Jannled/LedCube/Bilder/20170320_181509.jpg

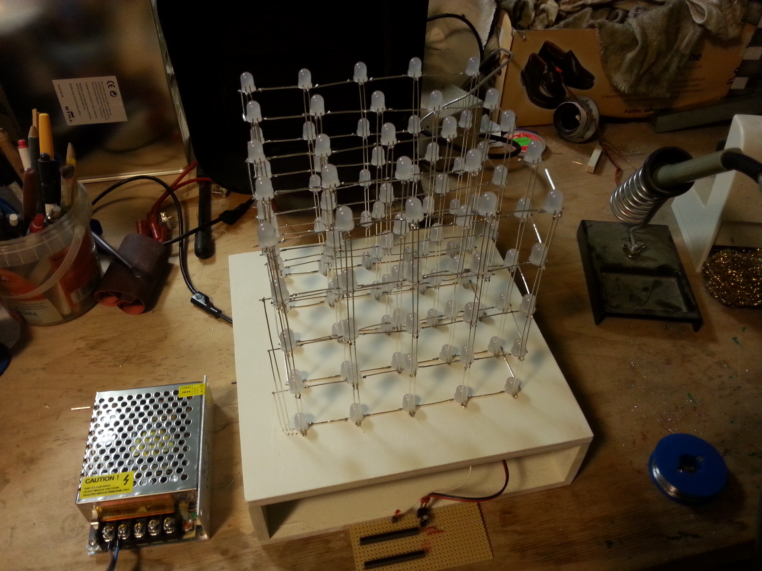
Bilder/20170320_181509.jpg
