Jannled/LedCube/Bilder/20170222_165625.jpg

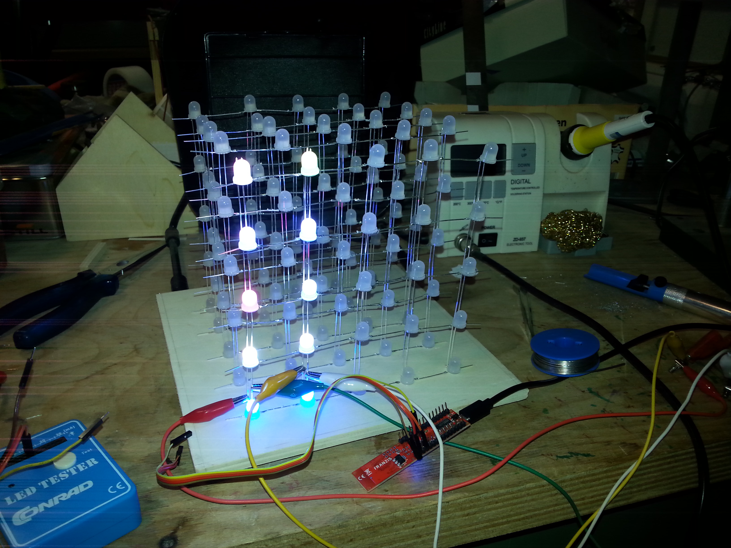
Bilder/20170222_165625.jpg
