Jannled/LedCube/README.md

# LedCube
Facharbeit 01 - Ansteuerung einer 5x5x5 LED-Matrix mit einem Microcontroller
