Jannled/LedCube/Abmessungen/rect4140.png

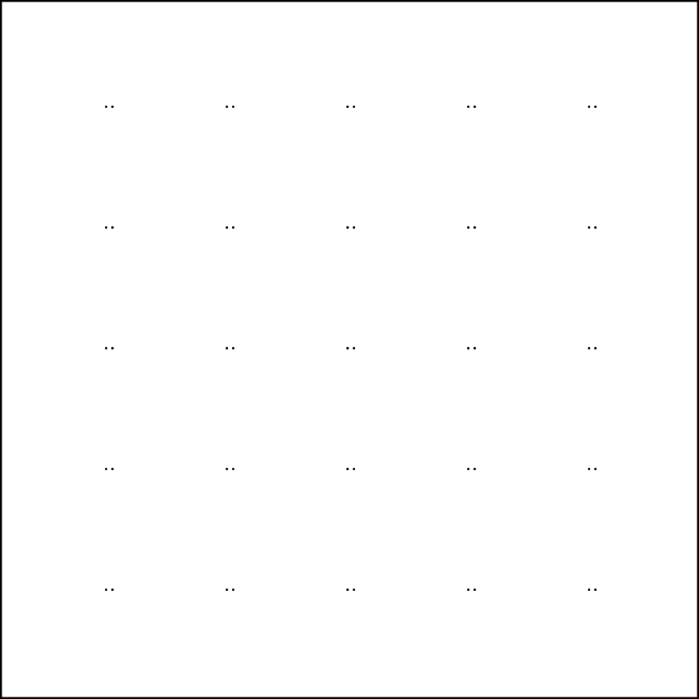
Abmessungen/rect4140.png
