Jannled/LedCube/Bilder/20170205_150405.jpg

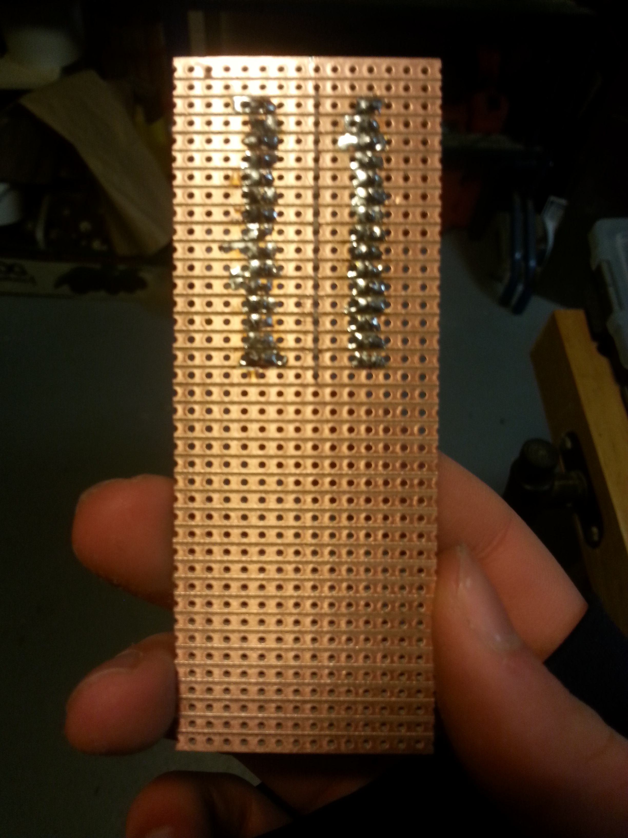
Bilder/20170205_150405.jpg
