Jannled/LedCube/Bilder/20170216_102611.jpg

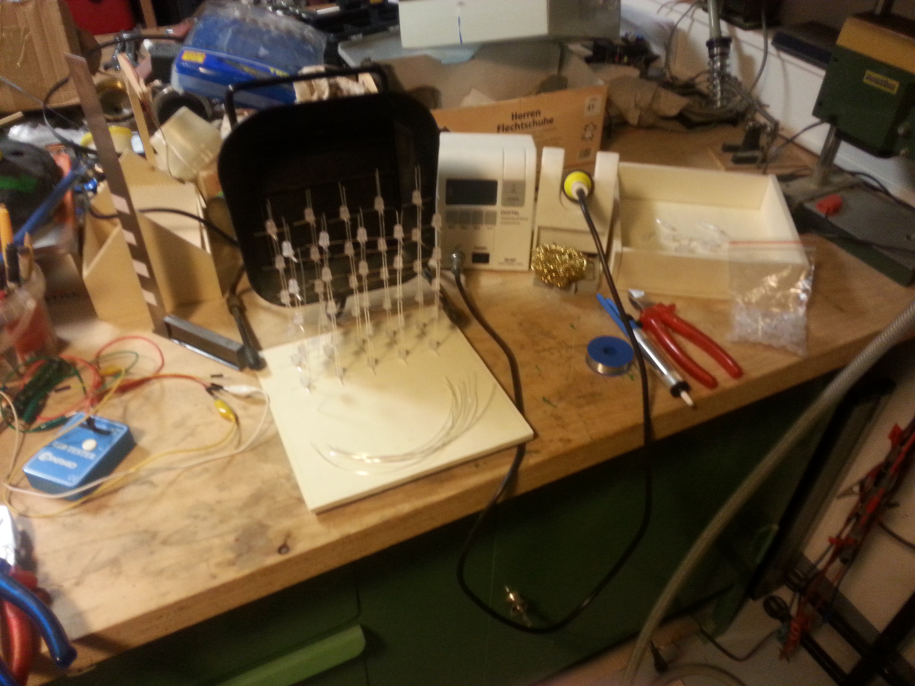
Bilder/20170216_102611.jpg
