Jannled/LedCube/Bilder/20170216_102615.jpg

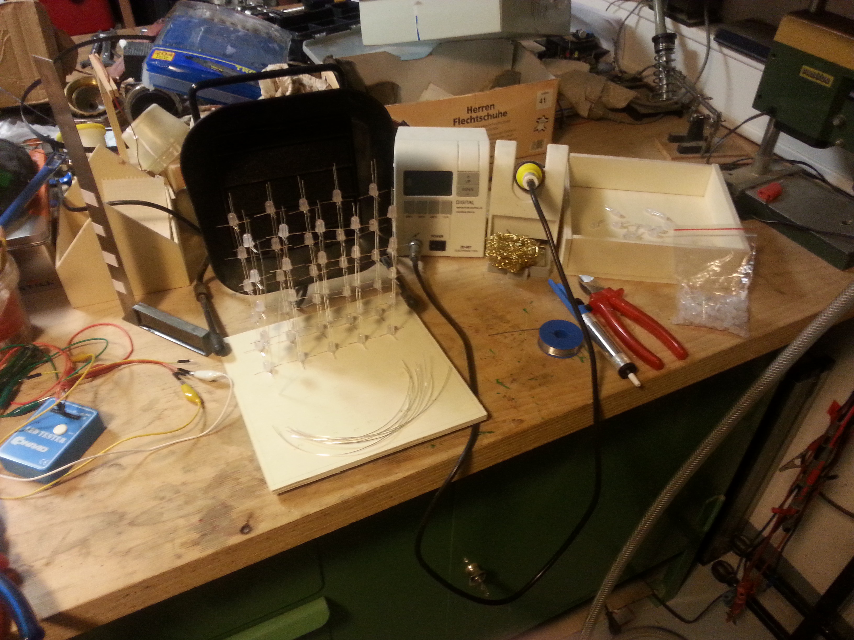
Bilder/20170216_102615.jpg
