Jannled/LedCube/Bilder/20170216_102635.jpg

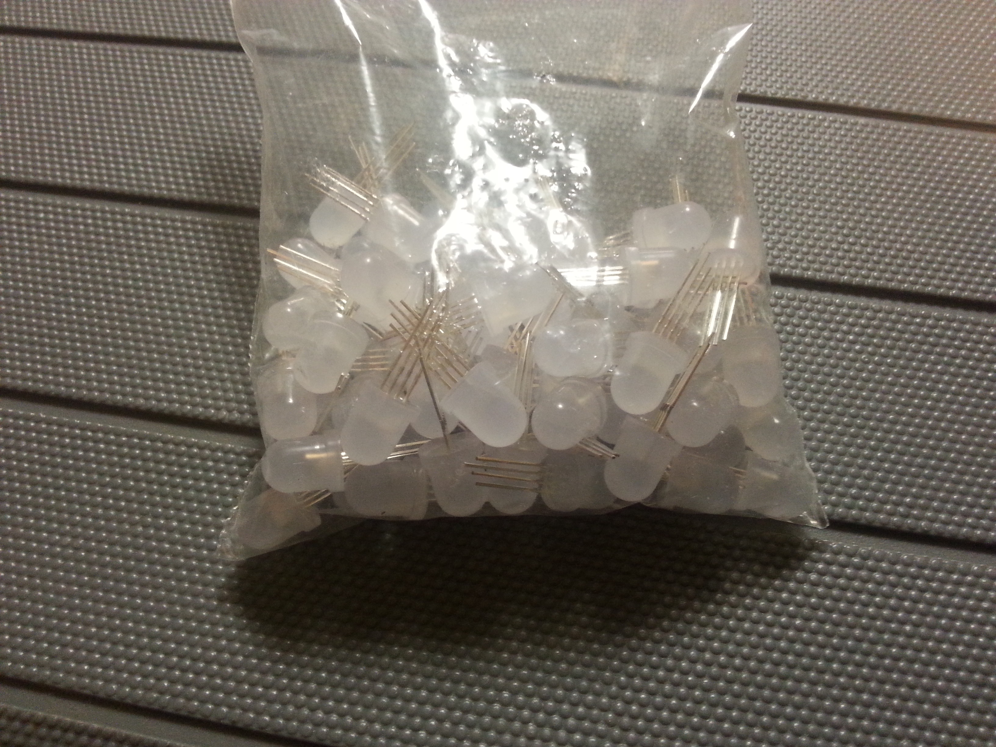
Bilder/20170216_102635.jpg
