Jannled/LedCube/Bilder/20170216_102642.jpg

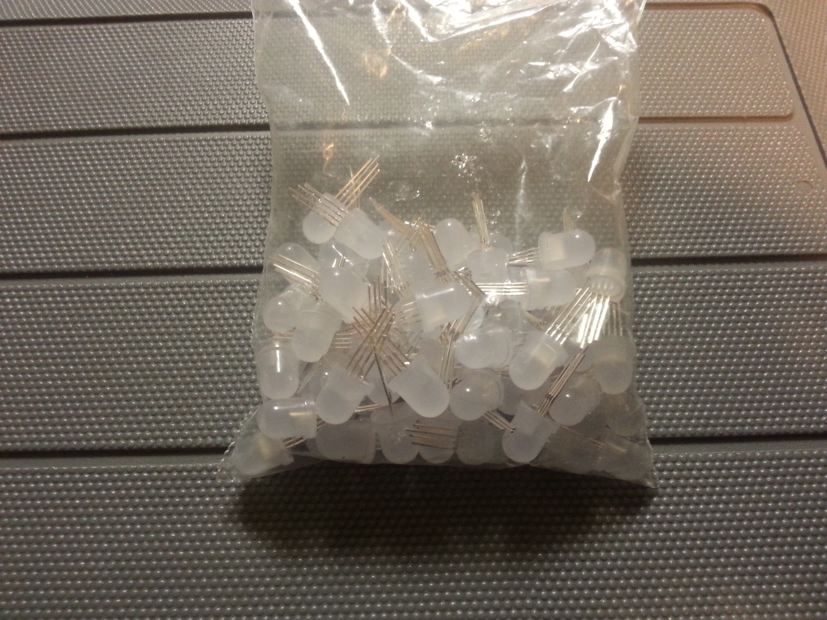
Bilder/20170216_102642.jpg
