Jannled/LedCube/Bilder/20170216_102648.jpg

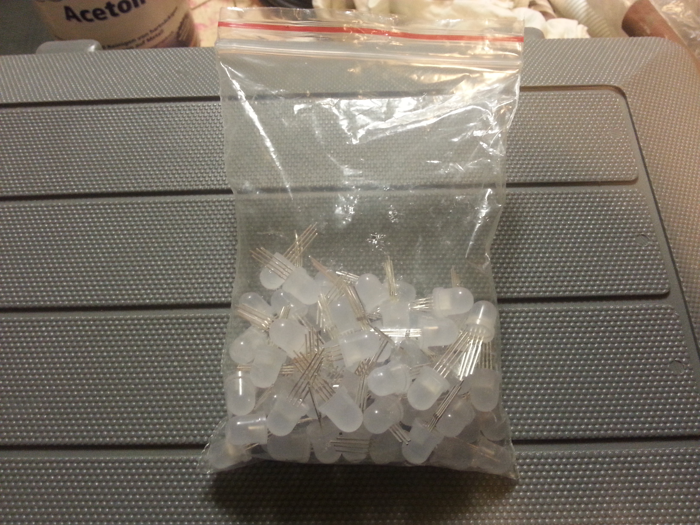
Bilder/20170216_102648.jpg
