Jannled/LedCube/Bilder/20170224_160457.jpg

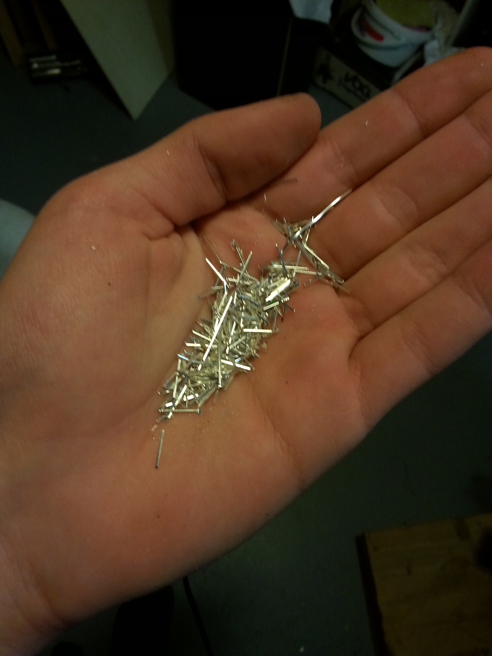
Bilder/20170224_160457.jpg
