Jannled/LedCube/Bilder/20170224_160502.jpg

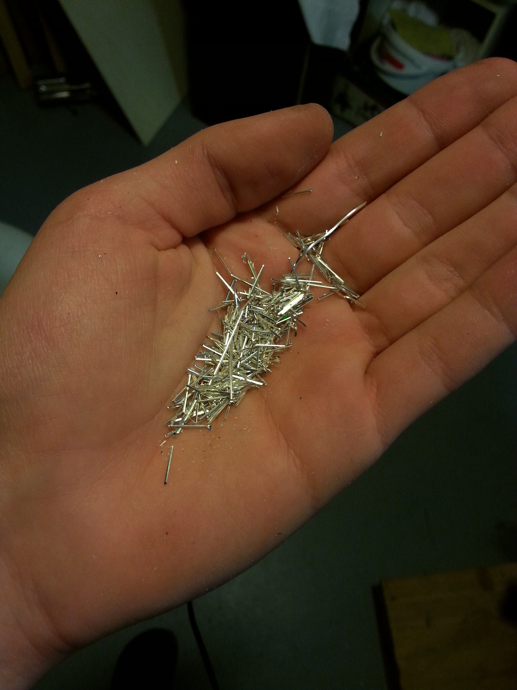
Bilder/20170224_160502.jpg
