Jannled/LedCube/Bilder/20170303_143246.jpg

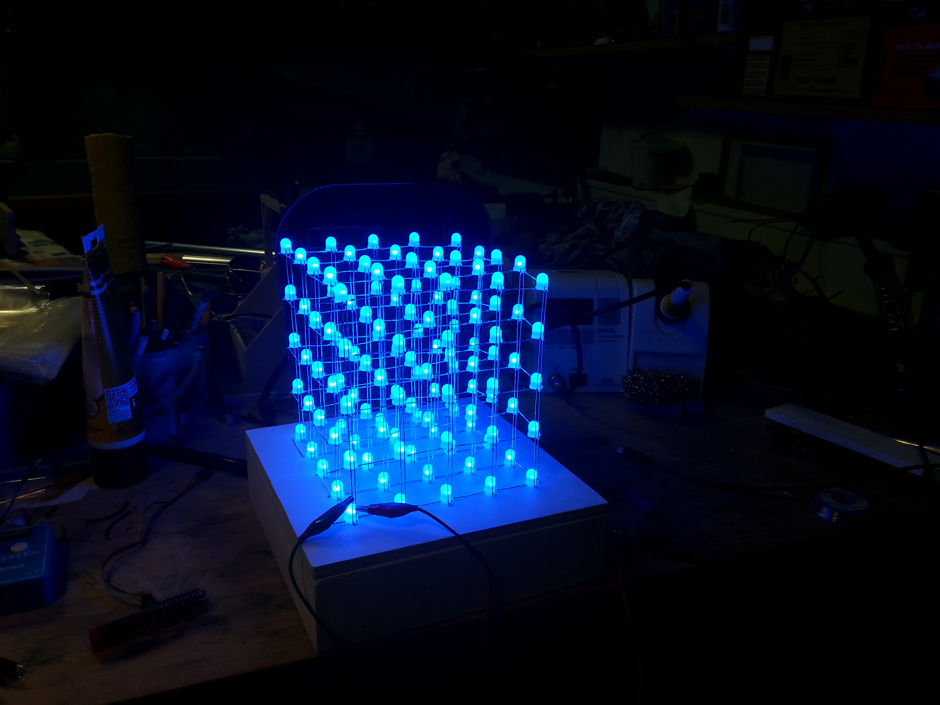
Bilder/20170303_143246.jpg
