Jannled/LedCube/Bilder/20170303_143307.jpg

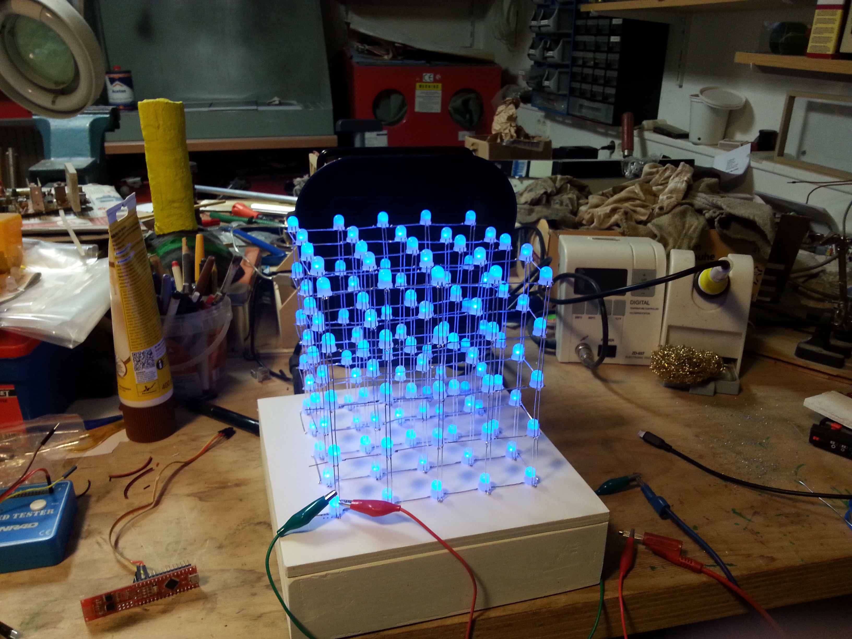
Bilder/20170303_143307.jpg
