Jannled/LedCube/Bilder/20170303_151015.jpg

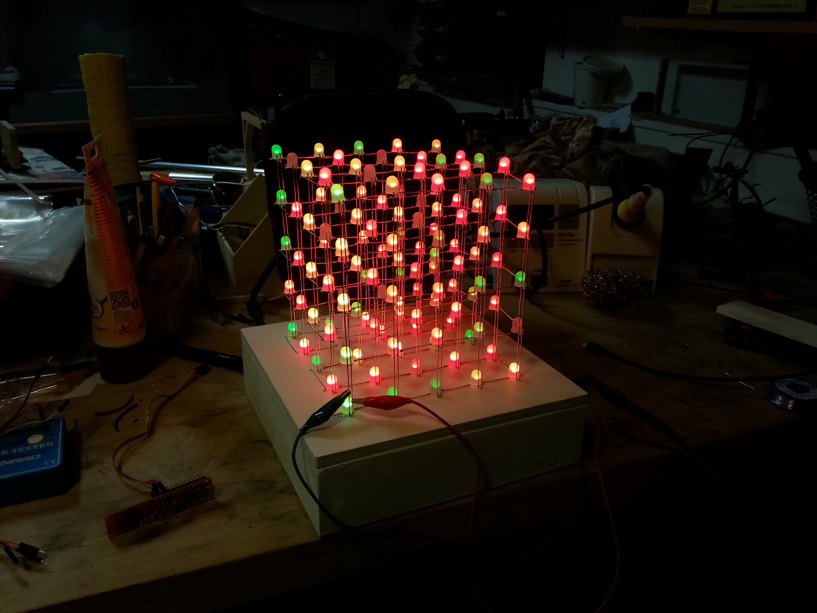
Bilder/20170303_151015.jpg
