Jannled/LedCube/Bilder/20170303_151024.jpg

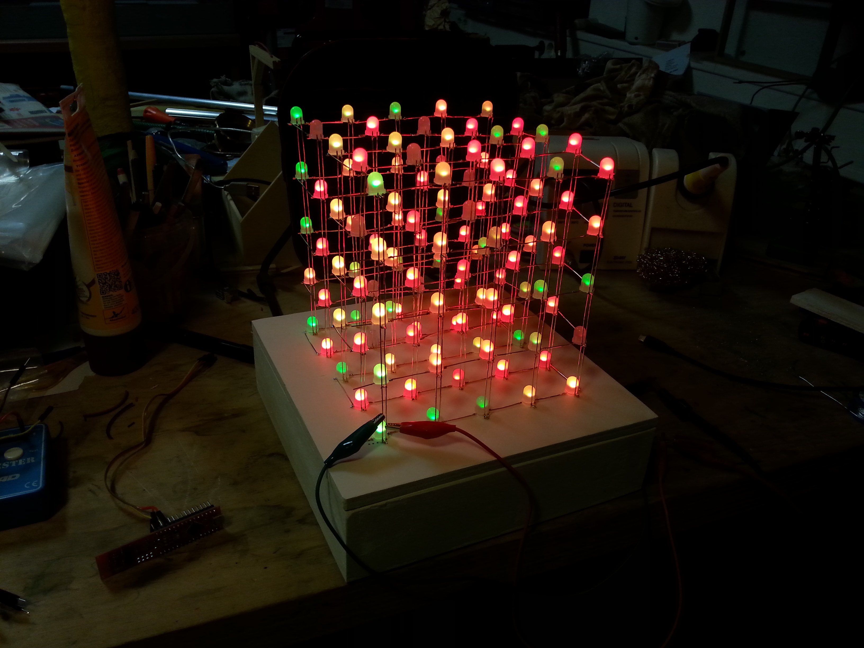
Bilder/20170303_151024.jpg
