Jannled/LedCube/Bilder/20170303_151113.jpg

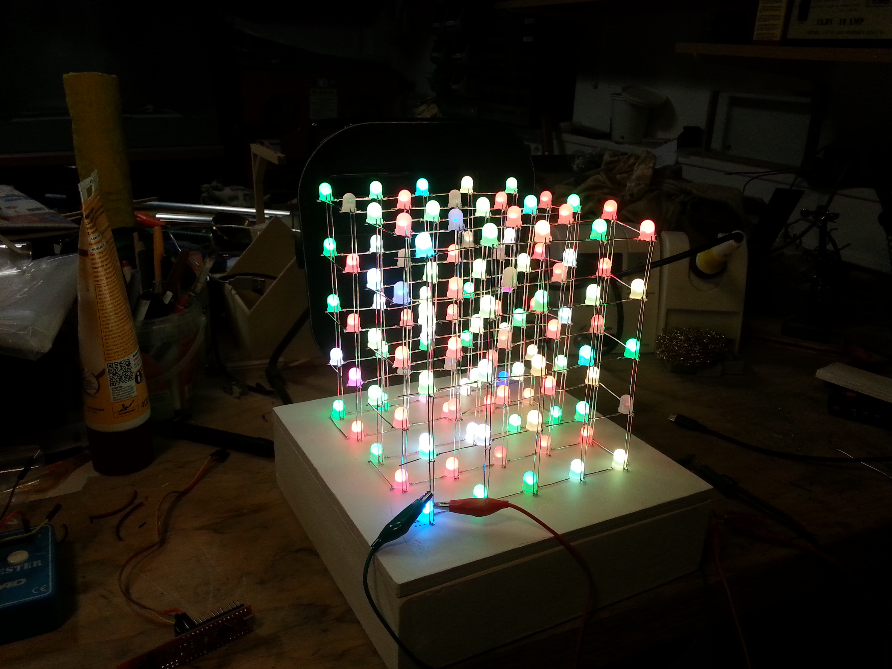
Bilder/20170303_151113.jpg
