Jannled/LedCube/Bilder/20170303_151120.jpg

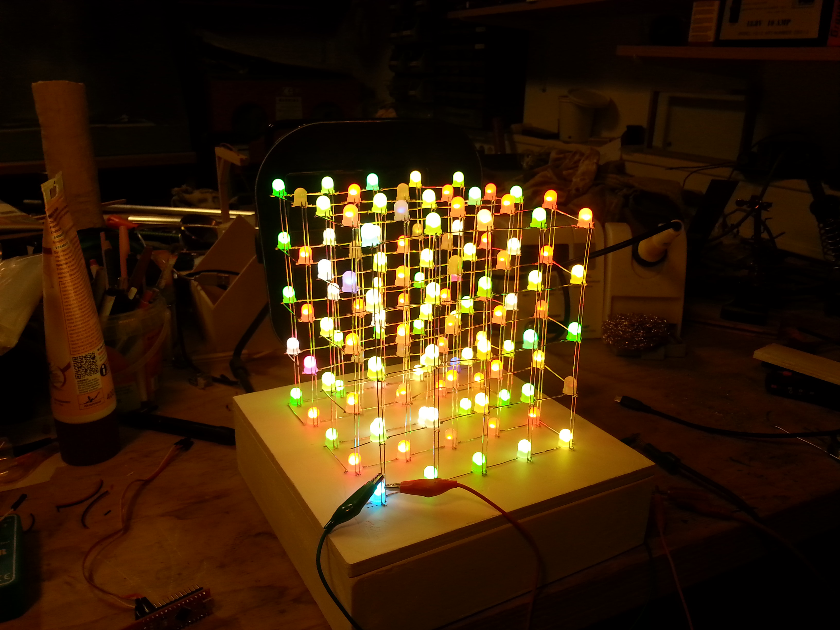
Bilder/20170303_151120.jpg
