Jannled/LedCube/Bilder/20170303_151130.jpg

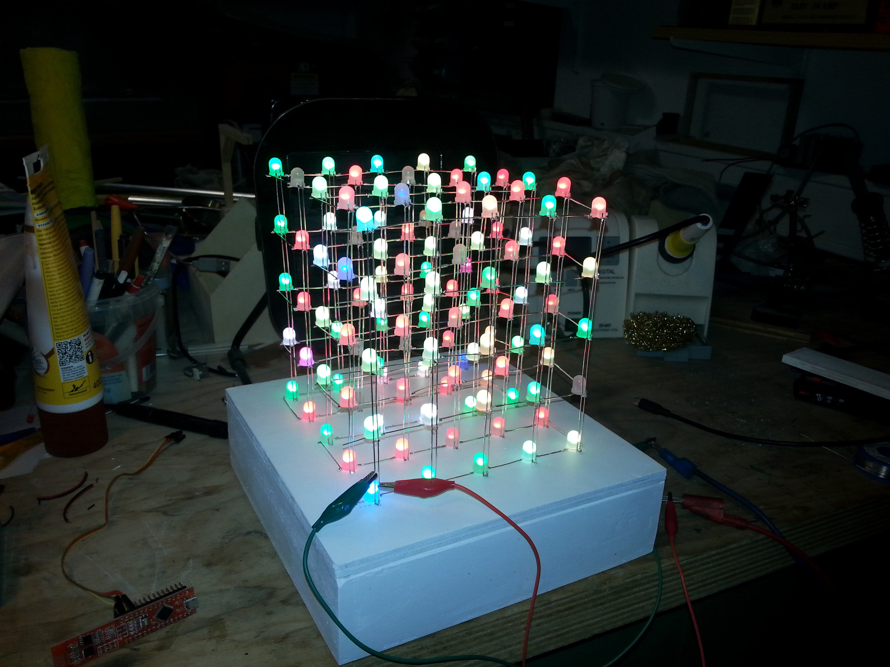
Bilder/20170303_151130.jpg
