Jannled/LedCube/Bilder/20170303_151159.jpg

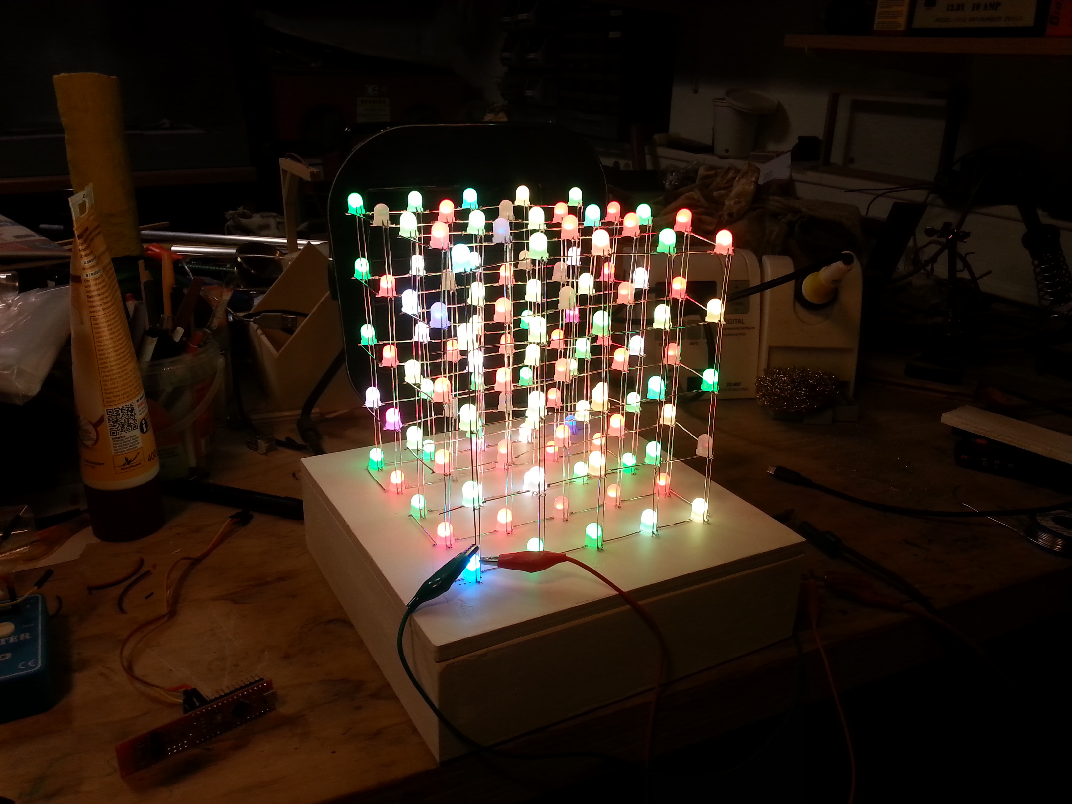
Bilder/20170303_151159.jpg
