Jannled/LedCube/Bilder/20170303_151203.jpg

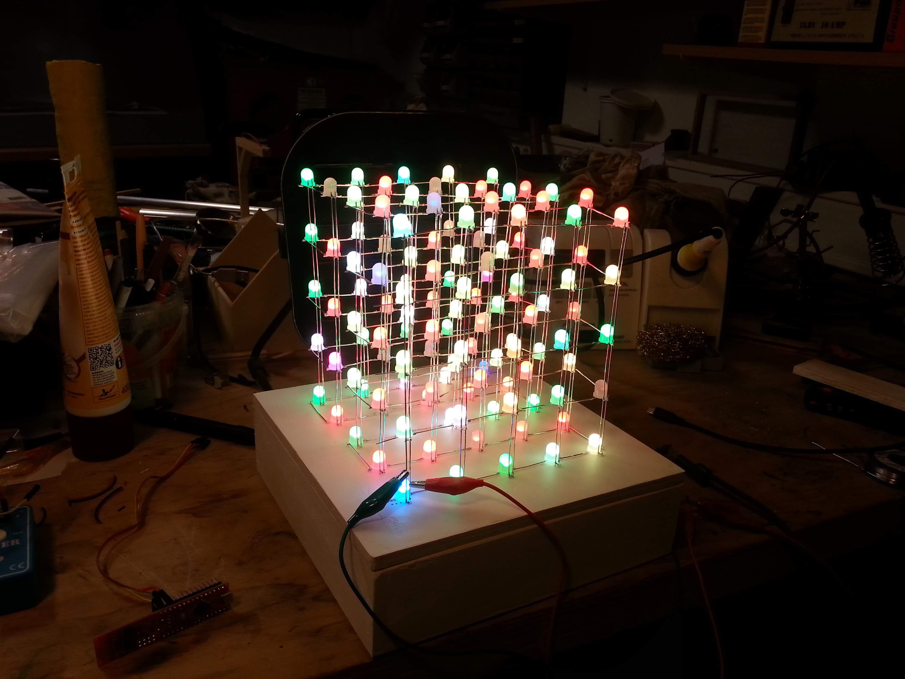
Bilder/20170303_151203.jpg
