Jannled/LedCube/Bilder/20170303_151218.jpg

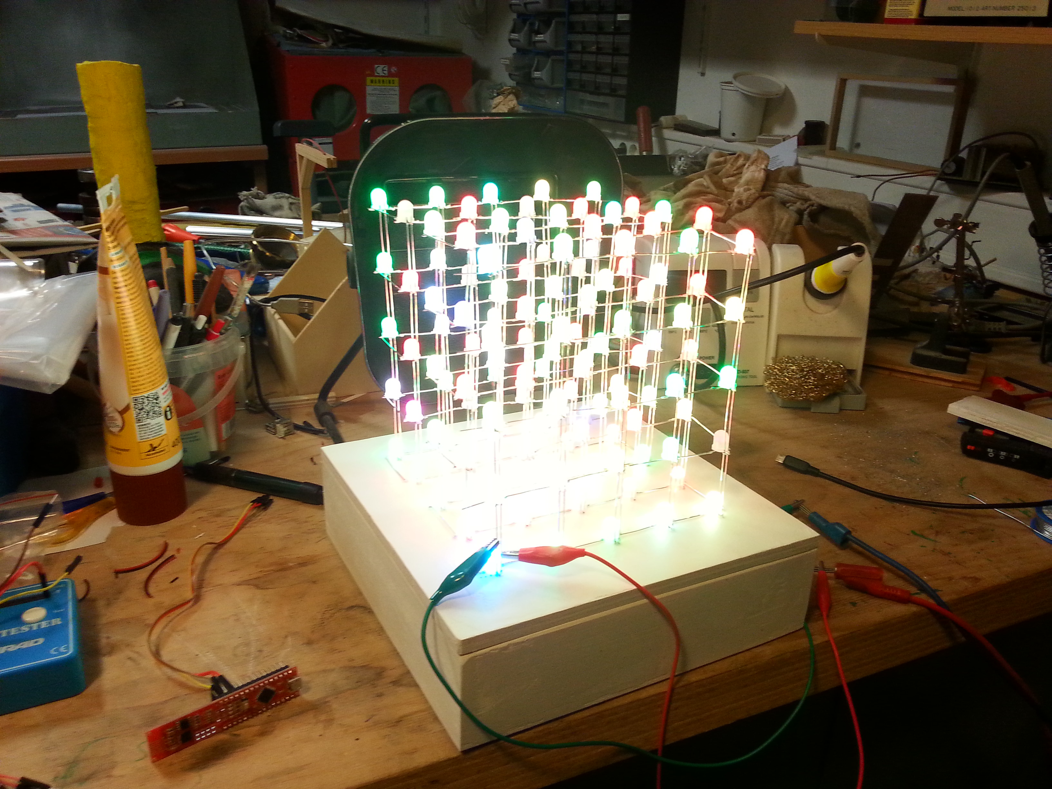
Bilder/20170303_151218.jpg
