Jannled/LedCube/Bilder/20170303_151224.jpg

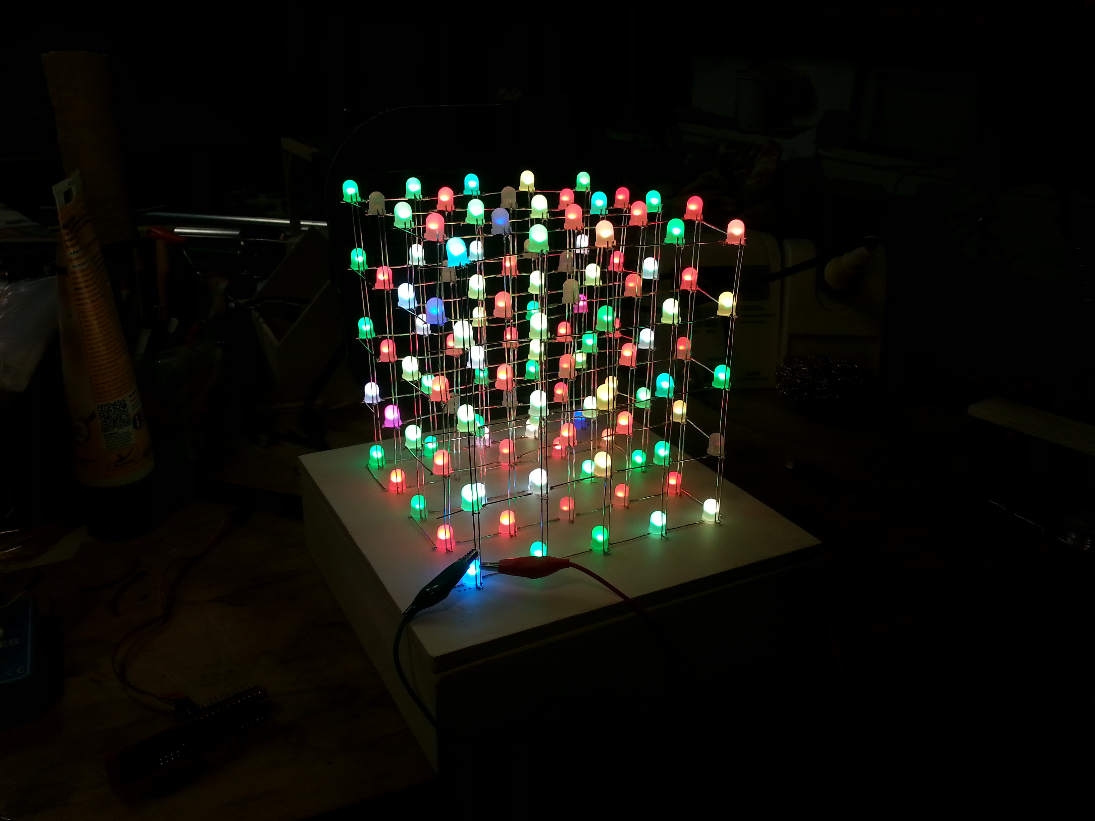
Bilder/20170303_151224.jpg
