Jannled/LedCube/Bilder/20170303_151228.jpg

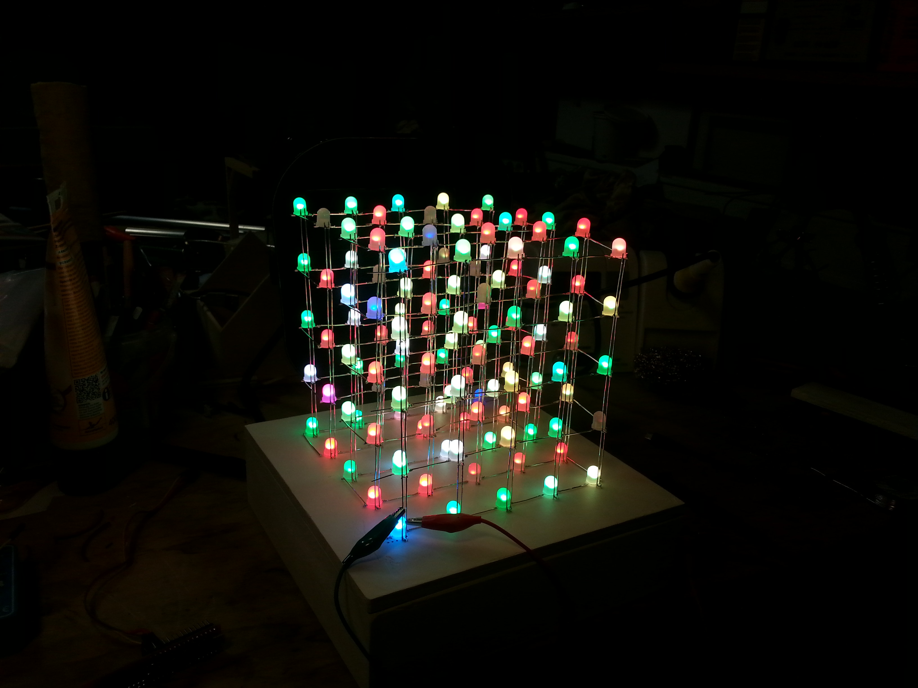
Bilder/20170303_151228.jpg
