Jannled/LedCube/Bilder/20170314_155006.jpg

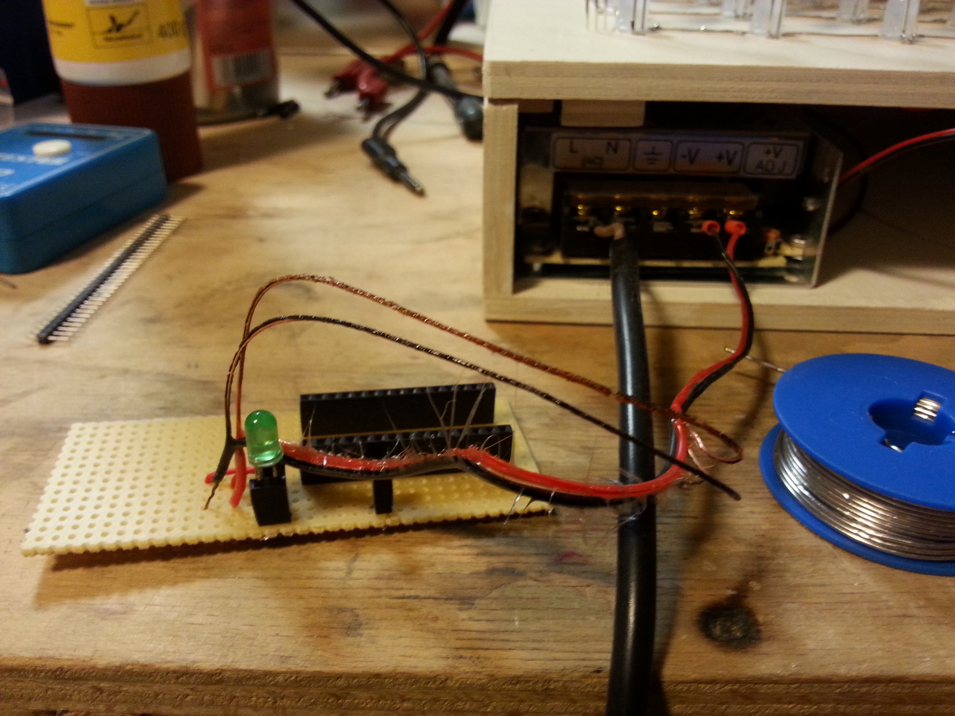
Bilder/20170314_155006.jpg
