Jannled/LedCube/Bilder/20170320_174735.jpg

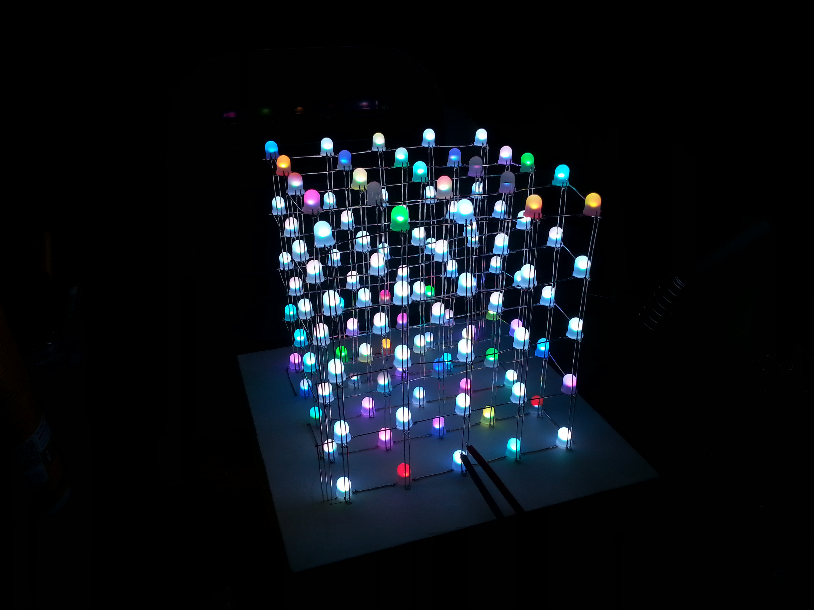
Bilder/20170320_174735.jpg
