Jannled/LedCube/Bilder/20170320_174758.jpg

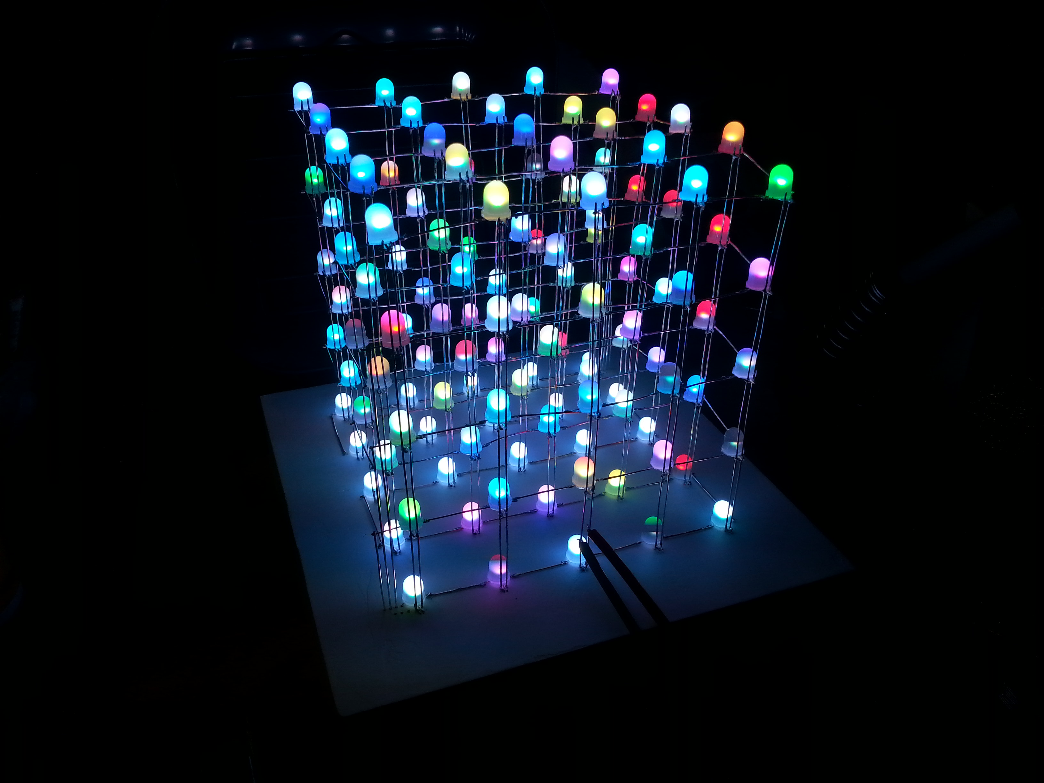
Bilder/20170320_174758.jpg
