Jannled/LedCube/Bilder/20170320_180738.jpg

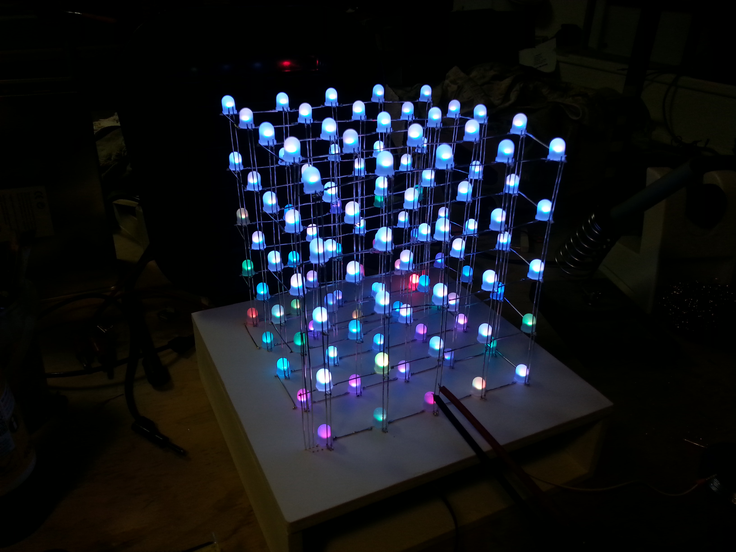
Bilder/20170320_180738.jpg
