Jannled/LedCube/Bilder/20170320_180744.jpg

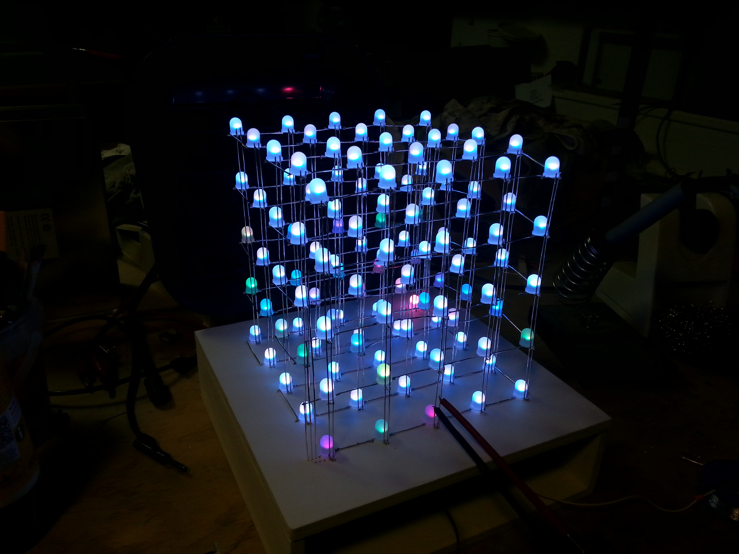
Bilder/20170320_180744.jpg
