Jannled/LedCube/Bilder/20170320_180808.jpg

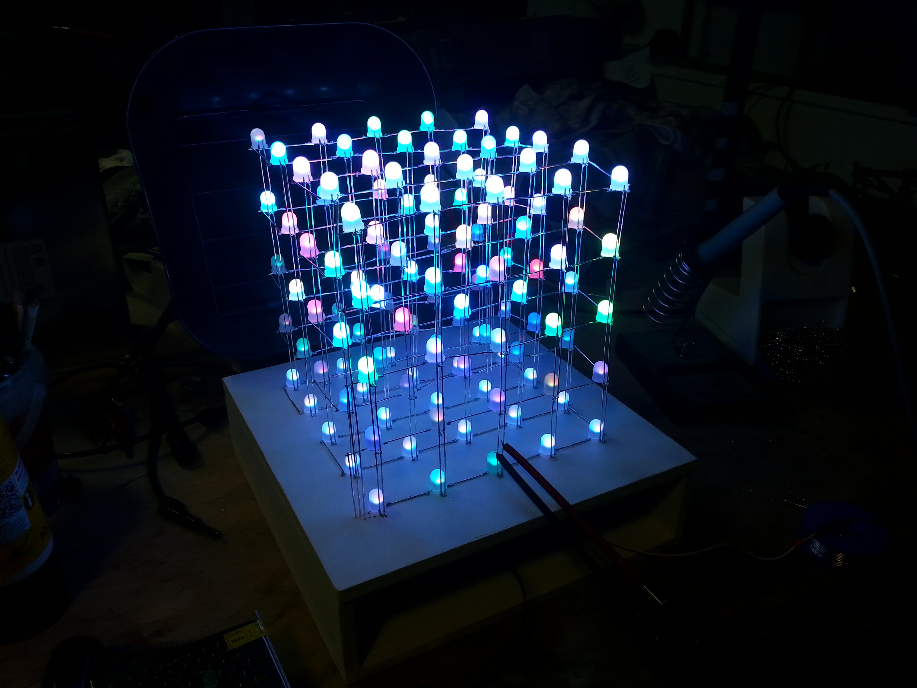
Bilder/20170320_180808.jpg
