Jannled/LedCube/Bilder/20170320_181129.jpg

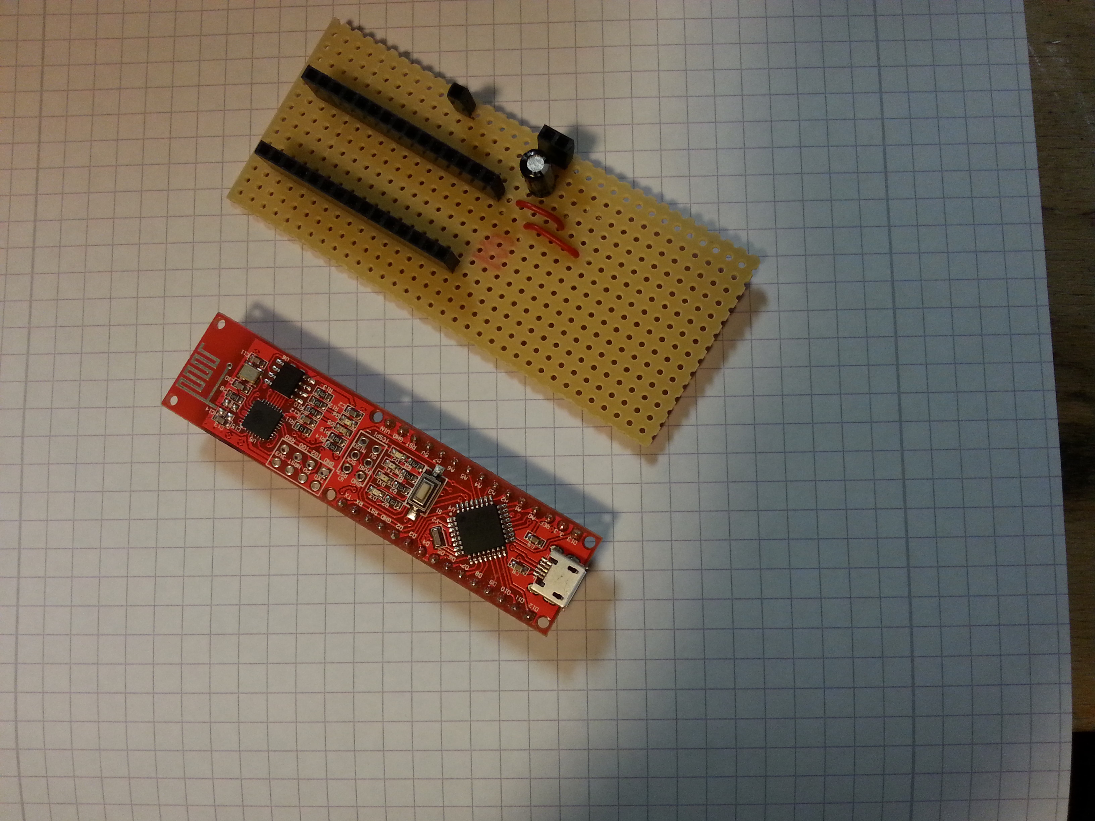
Bilder/20170320_181129.jpg
