Jannled/LedCube/Bilder/20170320_181212.jpg

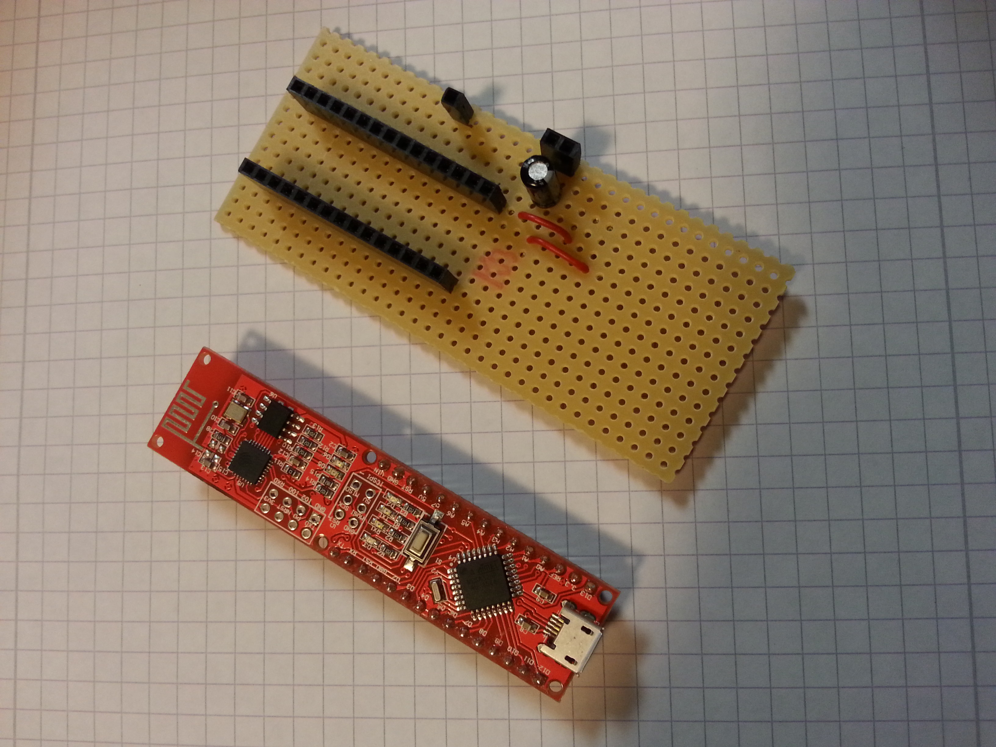
Bilder/20170320_181212.jpg
