Jannled/LedCube/Bilder/20170320_181306.jpg

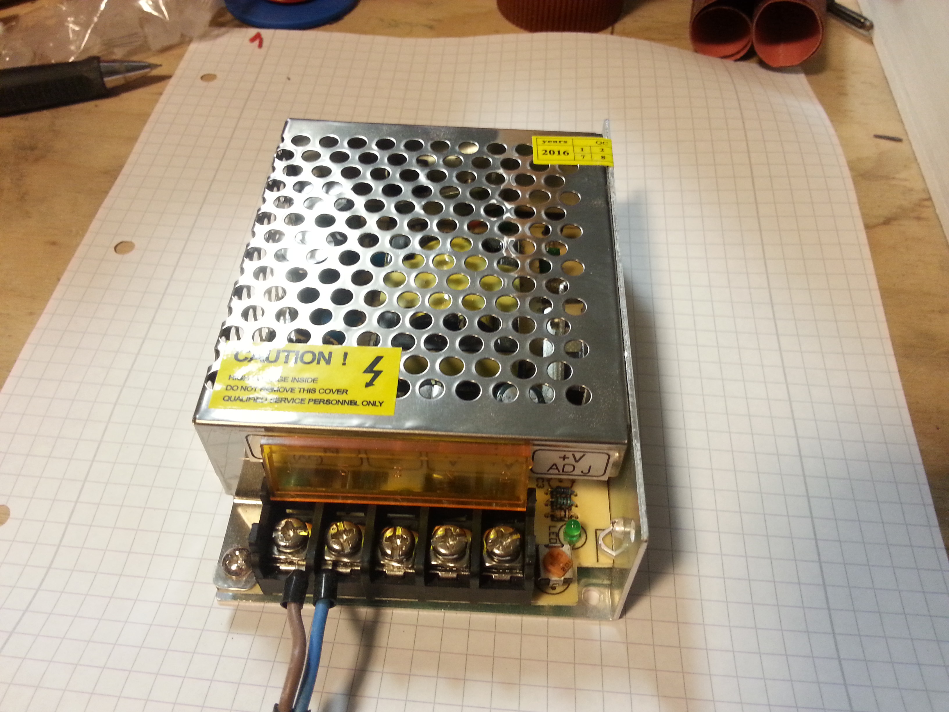
Bilder/20170320_181306.jpg
