Jannled/LedCube/Bilder/20170320_181319.jpg

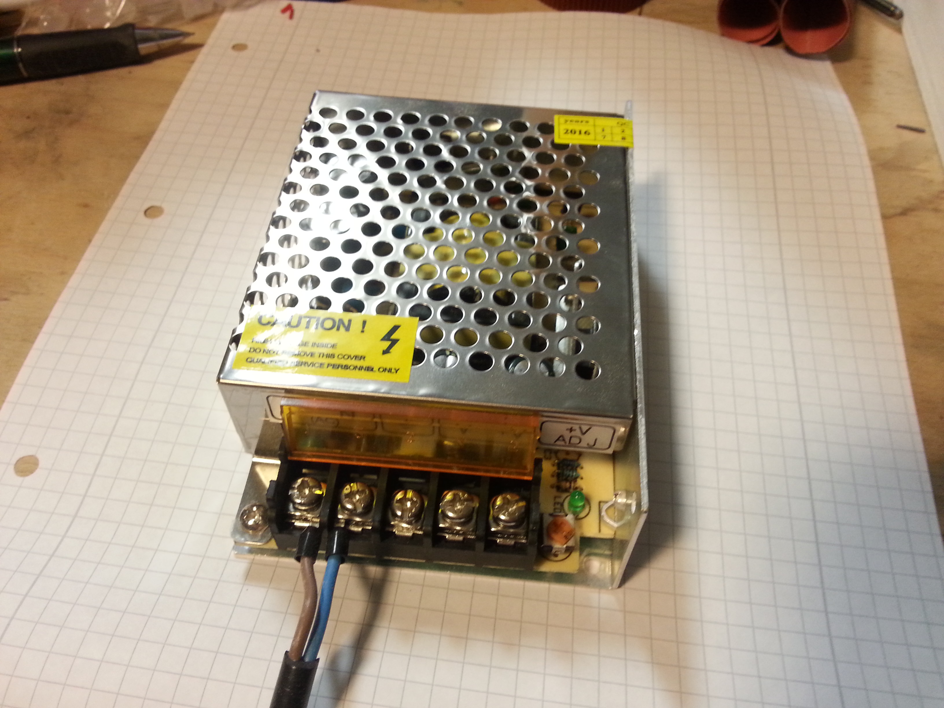
Bilder/20170320_181319.jpg
