Jannled/LedCube/Bilder/20170320_181413.jpg

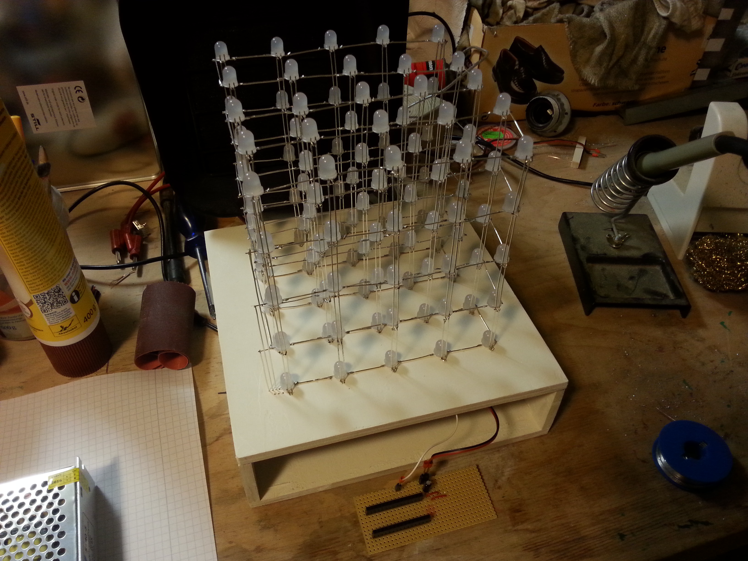
Bilder/20170320_181413.jpg
