Jannled/LedCube/Bilder/20170320_182445.jpg

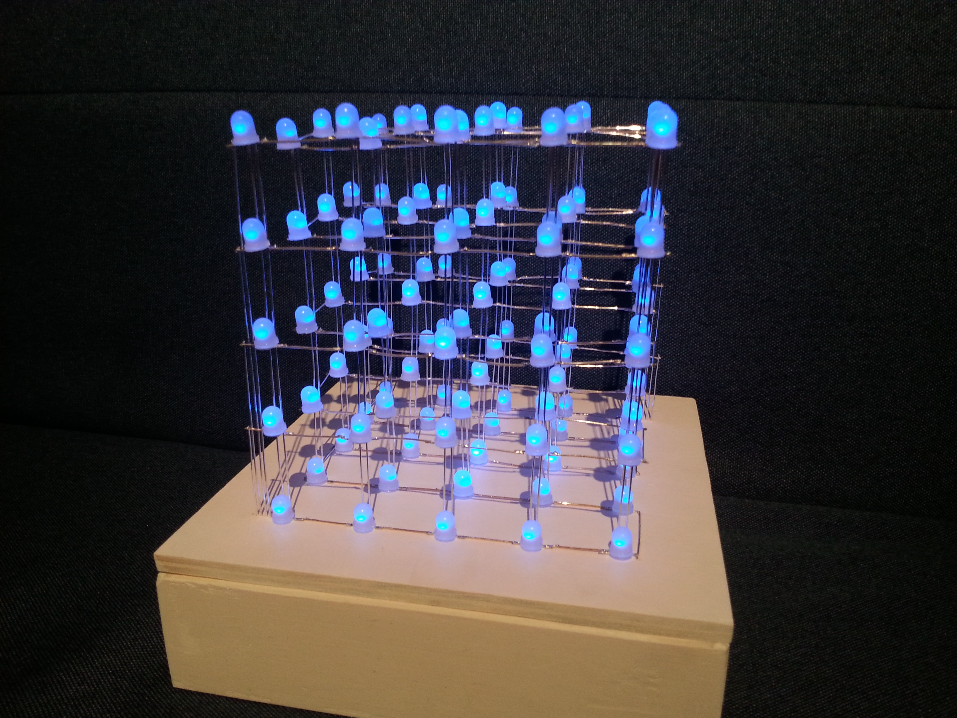
Bilder/20170320_182445.jpg
