Jannled/LedCube/Bilder/20170320_182454.jpg

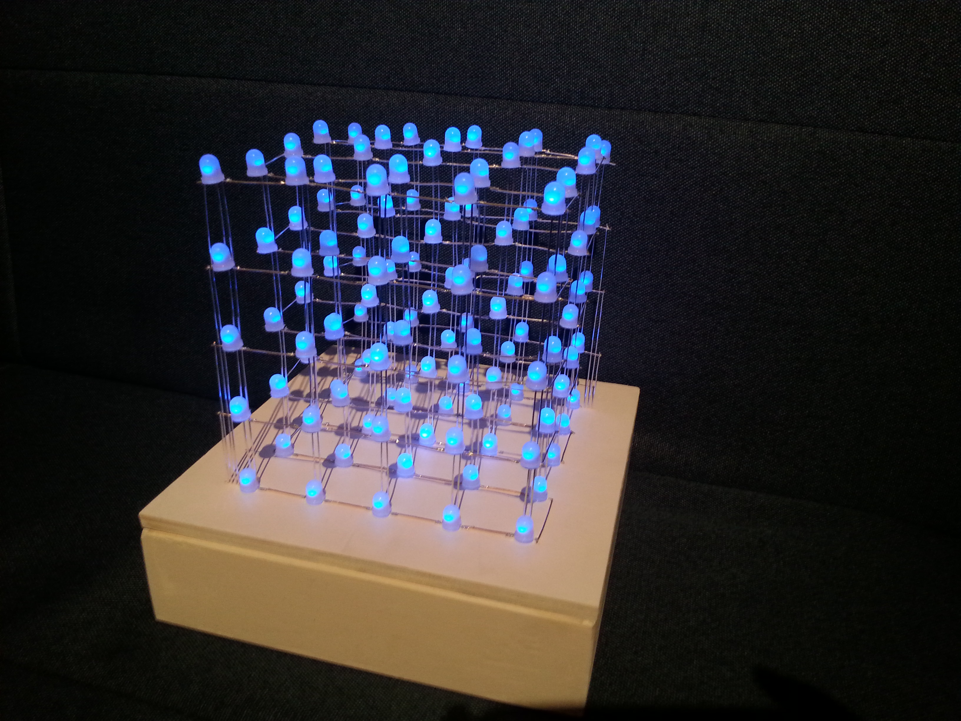
Bilder/20170320_182454.jpg
