Jannled/LedCube/Bilder/20170320_182537.jpg

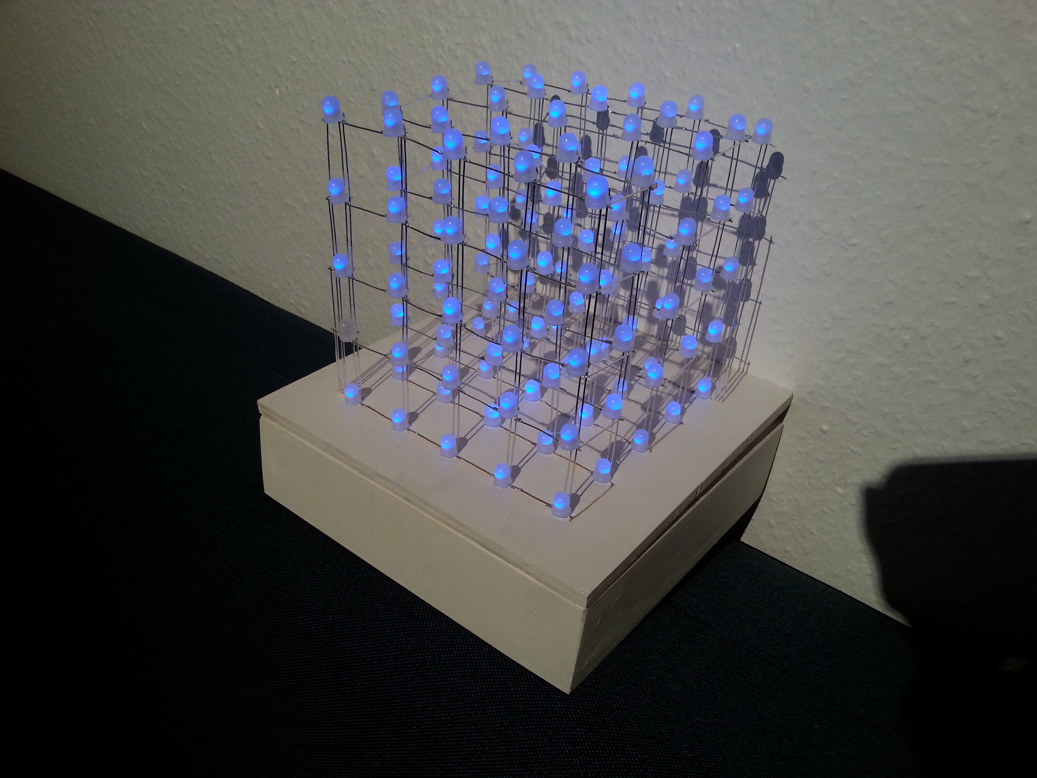
Bilder/20170320_182537.jpg
