Jannled/LedCube/Abmessungen/TopAbmessungen.pdf

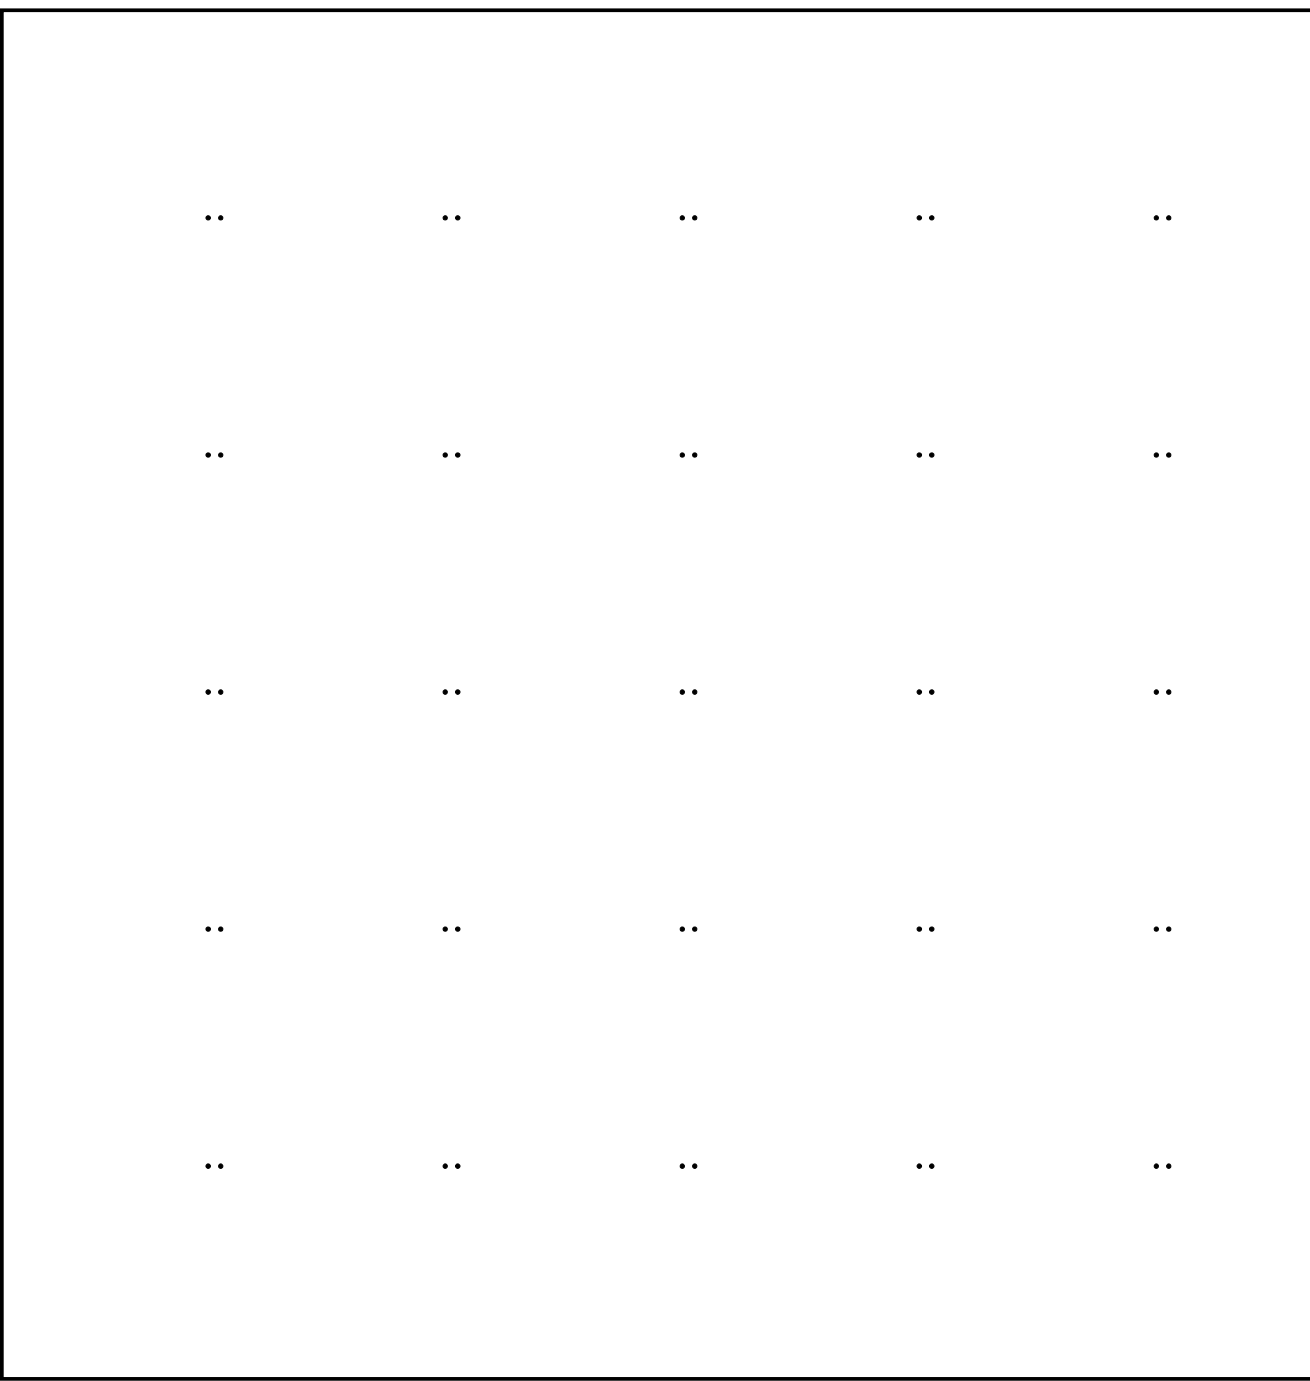
[picture p41: page 1]
