Jannled/LedCube/(commit log)

2017-02-22 Grundlegende Steine gesetzt für Facharbeit
    Programm angefangen zu schreiben
    Einige Skizzen für LED-Würfel enthalten
    Datei für Facharbeit erstellt
2017-02-22 Working on data transmission for the fist LED
    It is sending some data, but not what is desired...
2017-02-23 Try to get the data transmission to work
    Tried to use the specified nanoseconds for the WS2812B instead of the
    nanos from the PL9823 Datasheet, but it doesn't make a different.
    Tomorrow I will debug the code with time measurments for the bit code
    blocks.
    [LedCubeLib.ino]
2017-03-03 Push before fixing time issues
    Variables eat up a whole lot of time, at least two ticks per acces, this
    is one of the main speed issues. I now have to try to fix this issue by
    a workaround
    [LedCubeLib.ino]
2017-03-14 140317 Code und Text weitergearbeitet
2017-03-16 160317 Code und Text weiter gemacht
    Dran denken Buyken Termin machen!
2017-03-20 Finished!
    Wenn auch etwas verspätet, da ich noch den Code als Seite eingefügt
    habe, in der Printfassung musste ich etwas trickse, da ist der Code
    jetzt Seite 3 und kommt vor den handschriftlichen Notitzen
